SPROUT-MITLL/tip_mounts/media/tip_mount.png

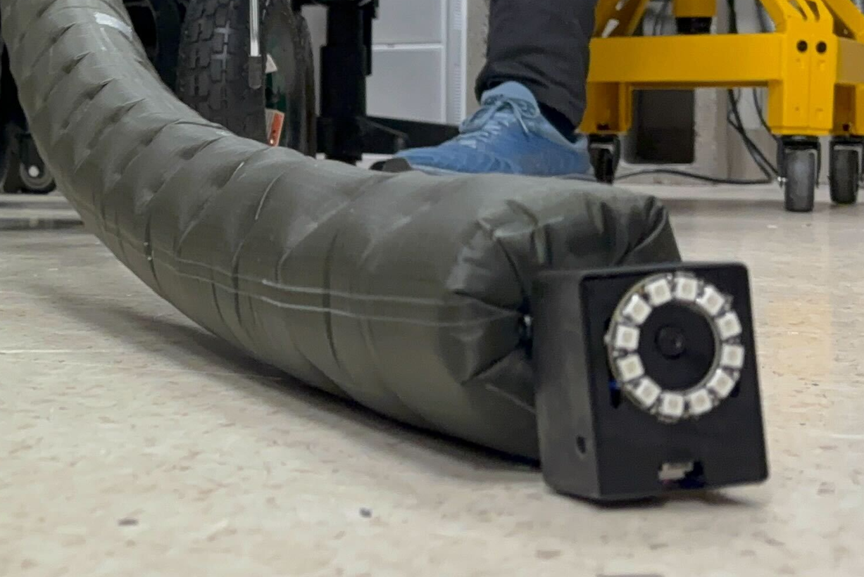
media/tip_mount.png
