SPROUT-MITLL/tip_mounts/media/mount.png

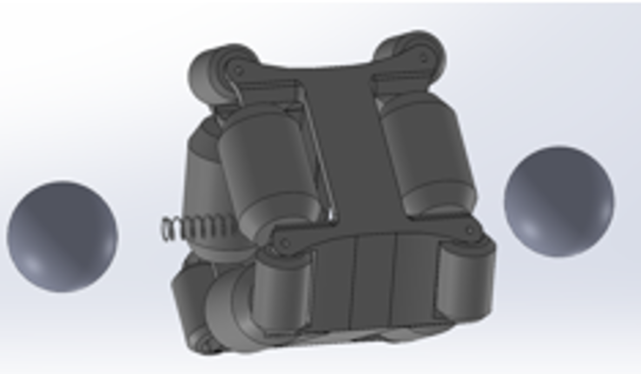
media/mount.png
