SPROUT-MITLL/tip_mounts/index_2.md

---
layout: default
title: Home
nav_order: 1
description: "Gotta Grow Fast"
permalink: /
---
<html lang="en-US">
<head>
  <meta charset="UTF-8">
  <meta name="viewport" content="width=device-width, initial-scale=1.0">
  <!--<link rel="stylesheet" href="style.css">-->
  <title>Gotta Grow Fast: Optimized Tip Mount & Benchmarking Methods for Growing Vine Robots</title>
</head>
<body>
  <div class="header-adder">
    <div class="title_set">
      <h1>Gotta Grow Fast: Optimized Tip Mount & Benchmarking Methods for Growing Vine Robots</h1>
    </div>
    <div class="names">
        <strong>
          Anonymous Authors
        </strong>
    </div>
  </div>
  <video width="1000" controls>
    <source src="media/gotta_grow_fast_v2.mp4" type="video/mp4">
  </video>

  <h2>Abstract</h2>
  <p>
  Soft, growing vine robots extend through tip eversion, a mechanism that enables navigation through cluttered environments. However, integrating cameras and other sensors at the tip is uniquely challenging because the material forming the tip is constantly renewed as the robot grows. This continual material turnover, combined with friction between internal layers, added tip weight, and fabric constriction, complicates sensor and tool mounting. These limitations hinder the deployment of vine robots for inspection and search tasks, where rapid growth while carrying tip-mounted sensors is essential.
  In this work, we present a triangular roller tip mount that reduces internal resistance during growth by rolling rather than sliding against the robot body. The design was refined through iterative failure analysis, enabling, for the first time, consistent eversion on a TPU-coated ripstop nylon vine robot.
  To quantitatively evaluate mount performance, we introduce a custom testbed that isolates tip-mounting effects by measuring tail tension during eversion. Comparative experiments across multiple mount variants, including prior designs, show that our triangular roller mount achieves the lowest tail tension and most repeatable growth performance.
  These results establish both a validated tip-mount design and a repeatable benchmarking framework for advancing sensor and tool integration in soft growing robots.
  </p>
</body>
</html>
---
