SPROUT-MITLL/tip_mounts/CAD/tip_mount/index.md

---
layout: default
title: Tip Mount CAD Files
nav_exclude: true
---

# Tip Mount CAD Files

[Back to Build Instructions](../../Build_Instructions){: .btn }

### 3D Preview: Camera Mount

{% include stl-viewer.html src="/media/camera_mount.stl" id="cad-camera-mount-viewer" %}

## Assembly

- [Final_Assembly.SLDASM](./Final_Assembly.SLDASM)

## Parts

- [rod.SLDPRT](./rod.SLDPRT)
- [sphere_anchor.SLDPRT](./sphere_anchor.SLDPRT)
- [V11_Small_Roller.SLDPRT](./V11_Small_Roller.SLDPRT)
- [V11_large_Roller.SLDPRT](./V11_large_Roller.SLDPRT)
- [V12_Half_Frame_Back_to_Back__SINGLE_PART_NOBORDER.SLDPRT](./V12_Half_Frame_Back_to_Back__SINGLE_PART_NOBORDER.SLDPRT)

## Purchased Hardware

- [6056N11_Carbon Steel Set Screw Collar.SLDPRT](./6056N11_Carbon%20Steel%20Set%20Screw%20Collar.SLDPRT)
