SPROUT-MITLL/tip_mounts/CAD/tip_mount/Final_Assembly.SLDASM

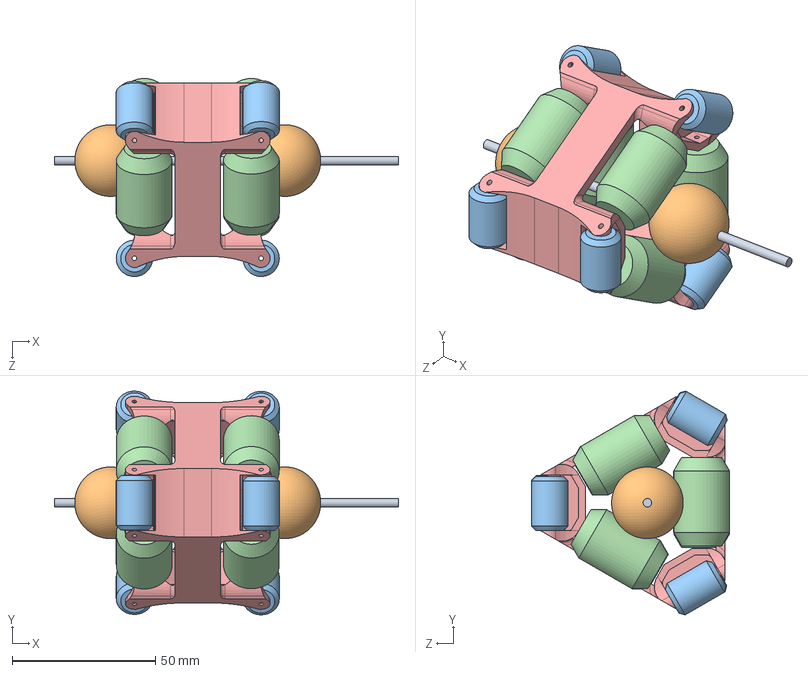
[picture p3: CAD file, 2025-11-18]
CAD/tip_mount/Final_Assembly.SLDASM
120.0 x 78.0 x 69.1 mm
V12_Half_Frame_Back_to_Back__SINGLE_PART_NOBORDER
V11_large_Roller x 6
V11_Small_Roller x 6
sphere_anchor x 2
rod
