SPROUT-MITLL/tip_mounts/CAD/test_bed/Short_Vine_Testbed_V1.SLDASM

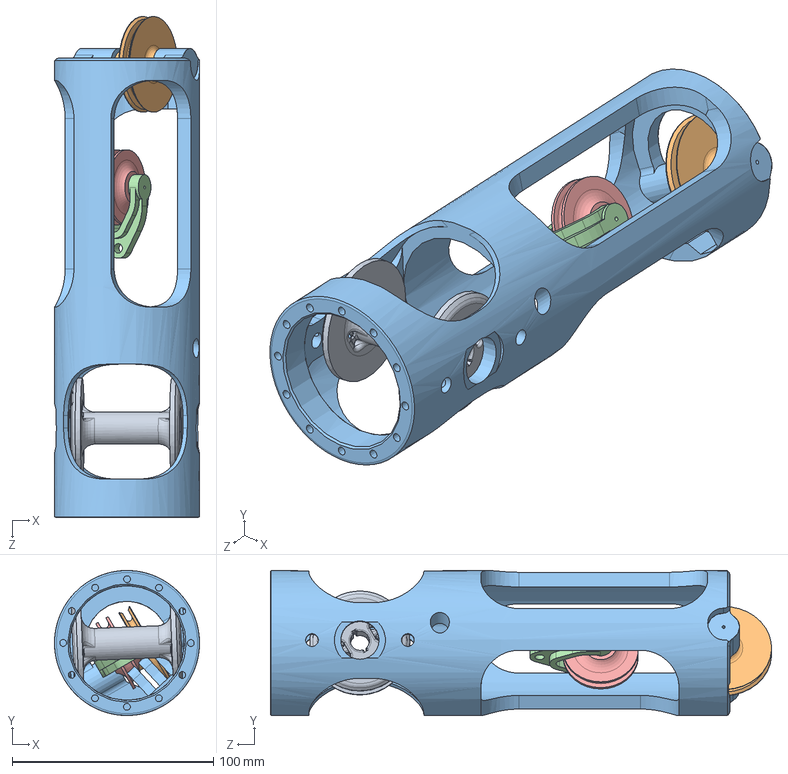
[picture p4: CAD file, 2025-11-18]
CAD/test_bed/Short_Vine_Testbed_V1.SLDASM
72.1 x 72.1 x 249.1 mm
Force_Sensor_Pulley
Force_Sensor_Pulley_Bracket
Force_Sensor_Stationary_Mount_Bracket
Return_Wheel
vine_retract_cable_reel
