SPROUT-MITLL/tip_mounts/CAD/test_bed/Sensor_Pulley_Bracket_Assembly.SLDASM

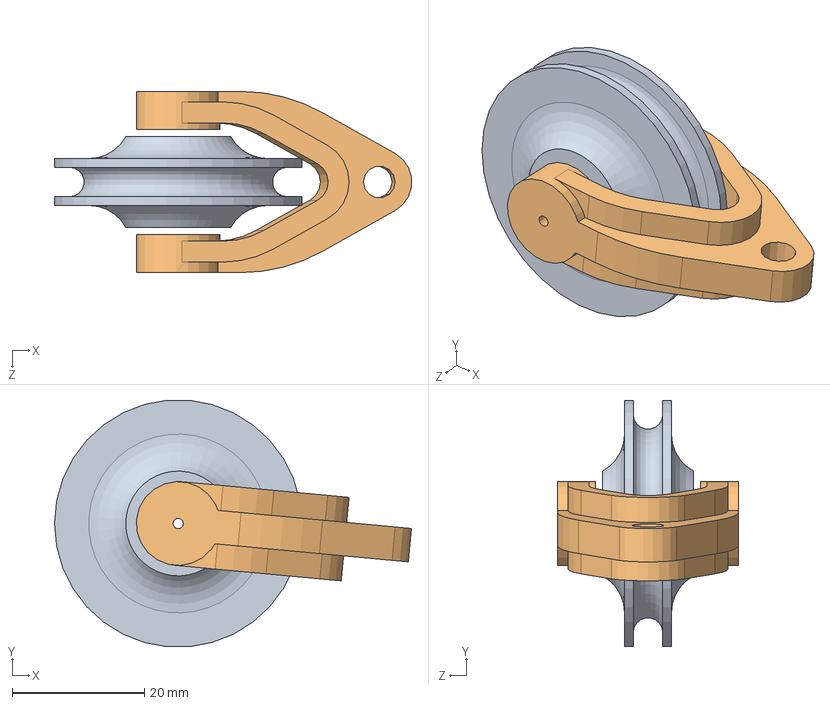
[picture p5: CAD file, 2025-11-18]
CAD/test_bed/Sensor_Pulley_Bracket_Assembly.SLDASM
54.1 x 37.3 x 27.4 mm
Force_Sensor_Pulley
Force_Sensor_Pulley_Bracket
