SPROUT-MITLL/tip_mounts/CAD/tip_mount/sphere_anchor.SLDPRT

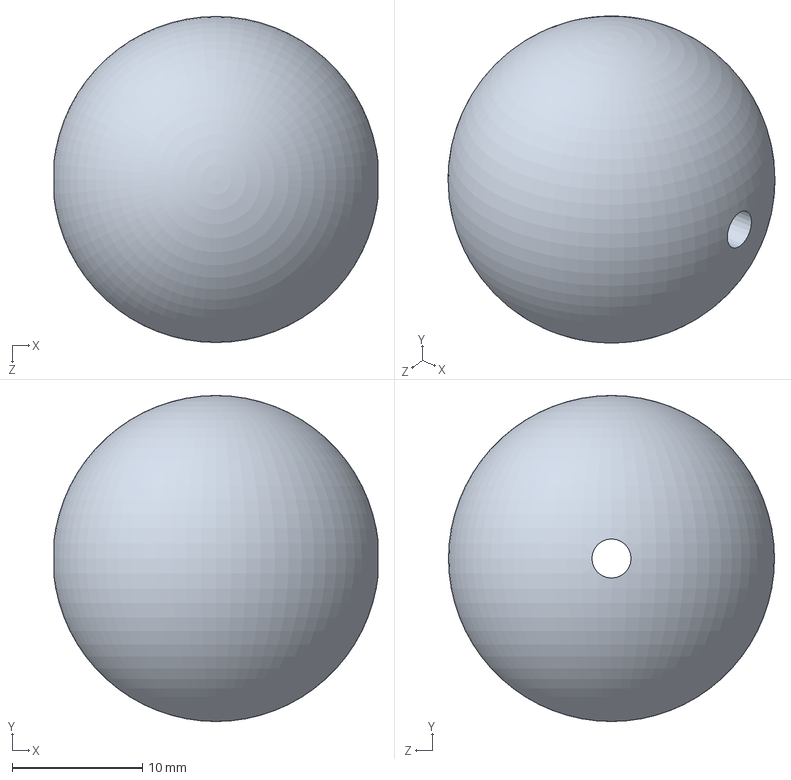
[picture p6: CAD file, 2025-11-18]
CAD/tip_mount/sphere_anchor.SLDPRT
24.8 x 25.0 x 25.0 mm
