SPROUT-MITLL/tip_mounts/media/camera_mount.stl

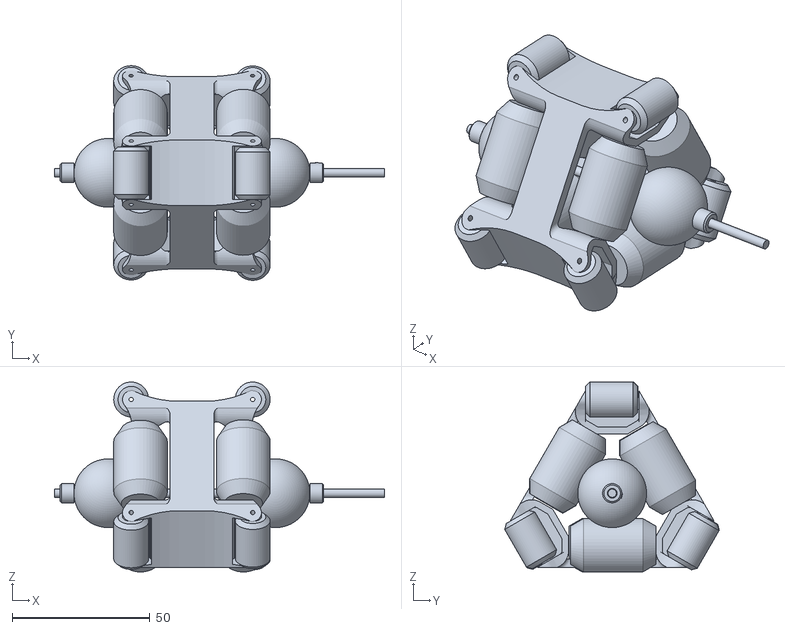
[picture p7: CAD file, 2026-08-28]
media/camera_mount.stl
120.0 x 78.1 x 69.1
