SPROUT-MITLL/tip_mounts/CAD/test_bed/Return_Wheel.SLDPRT

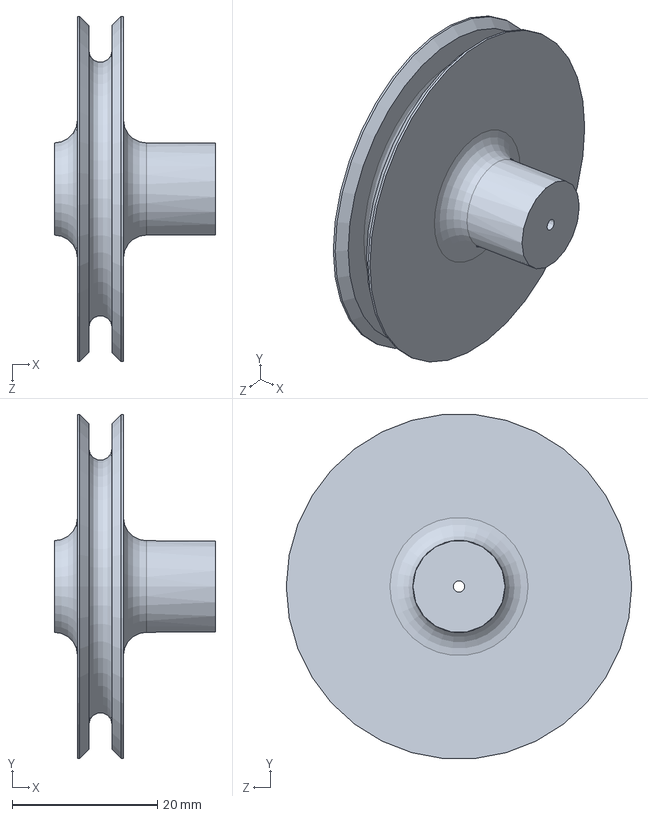
[picture p8: CAD file, 2025-11-18]
CAD/test_bed/Return_Wheel.SLDPRT
22.2 x 47.4 x 47.6 mm
