SPROUT-MITLL/tip_mounts/CAD/tip_mount/rod.SLDPRT

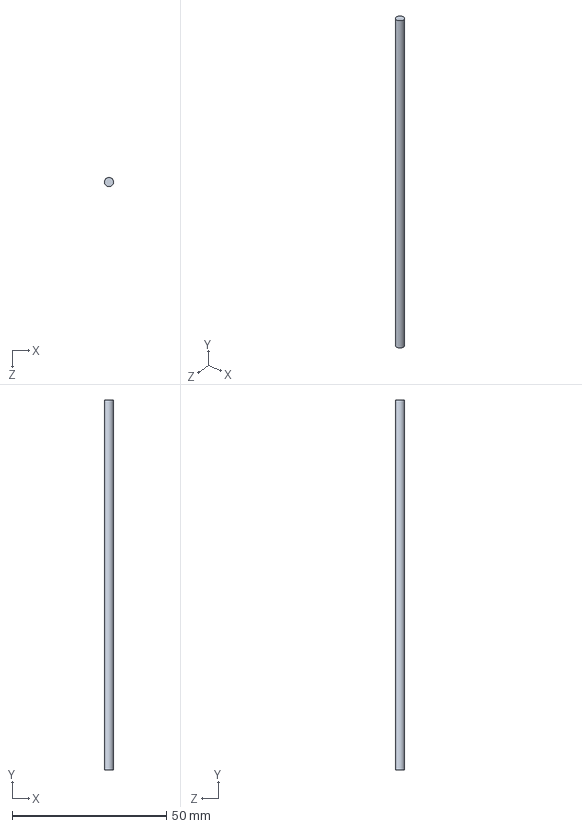
[picture p9: CAD file, 2025-11-18]
CAD/tip_mount/rod.SLDPRT
2.99 x 120.0 x 3.00 mm
