SPROUT-MITLL/tip_mounts/CAD/test_bed/vine_retract_cable_reel.SLDPRT

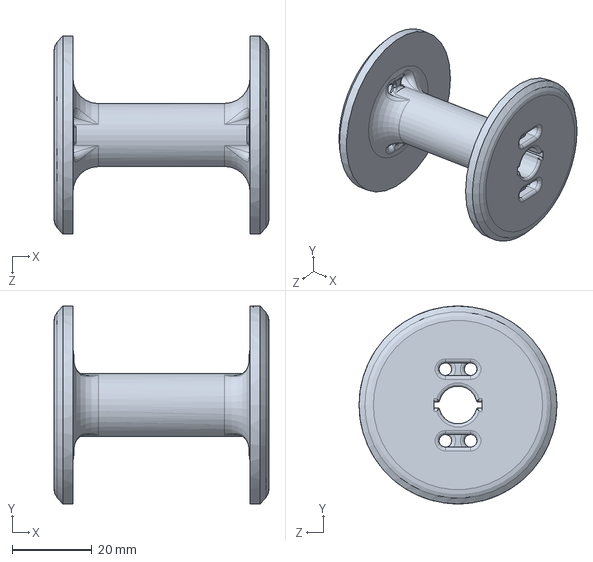
[picture p10: CAD file, 2025-11-18]
CAD/test_bed/vine_retract_cable_reel.SLDPRT
54.0 x 49.7 x 49.7 mm
