SPROUT-MITLL/tip_mounts/CAD/tip_mount/V11_Small_Roller.SLDPRT

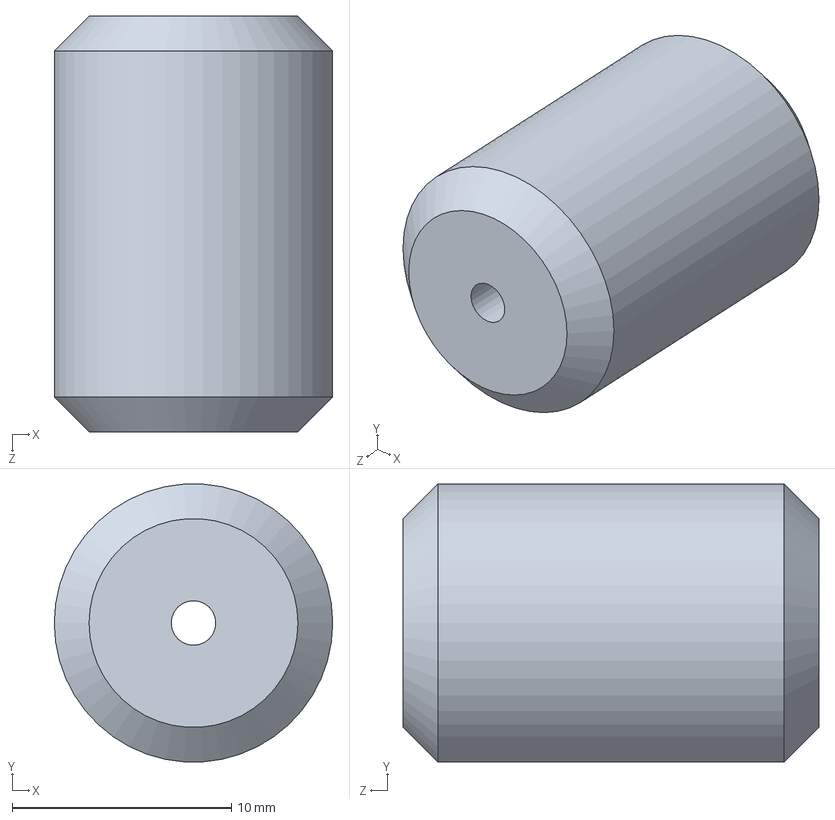
[picture p11: CAD file, 2025-11-18]
CAD/tip_mount/V11_Small_Roller.SLDPRT
12.7 x 12.7 x 19.0 mm
