SPROUT-MITLL/tip_mounts/CAD/test_bed/PTFE ring.SLDPRT

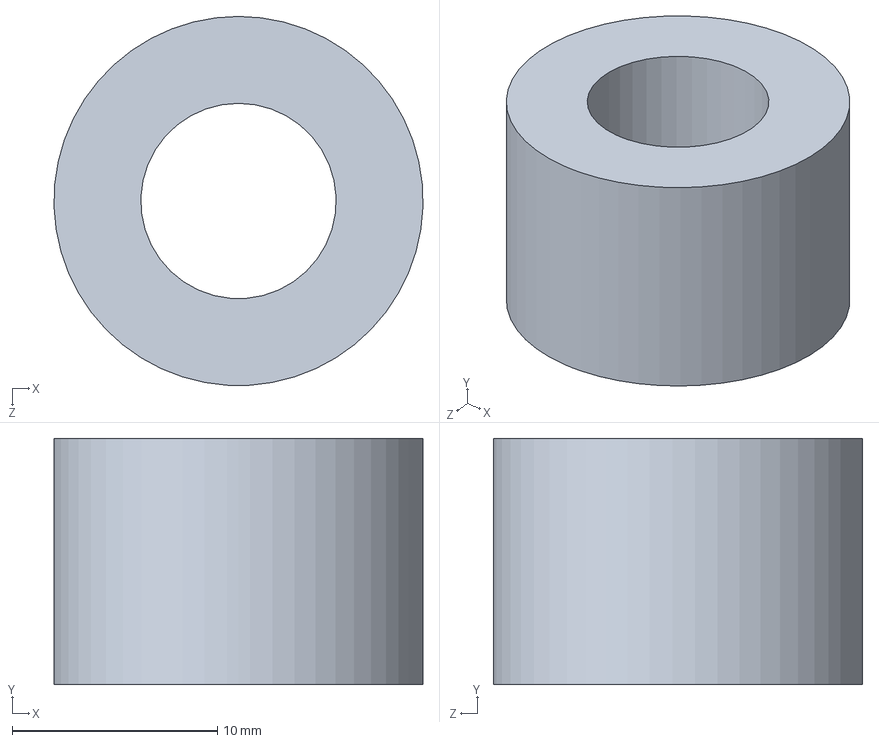
[picture p12: CAD file, 2025-11-18]
CAD/test_bed/PTFE ring.SLDPRT
18.0 x 12.0 x 18.0 mm
