SPROUT-MITLL/tip_mounts/CAD/tip_mount/V11_large_Roller.SLDPRT

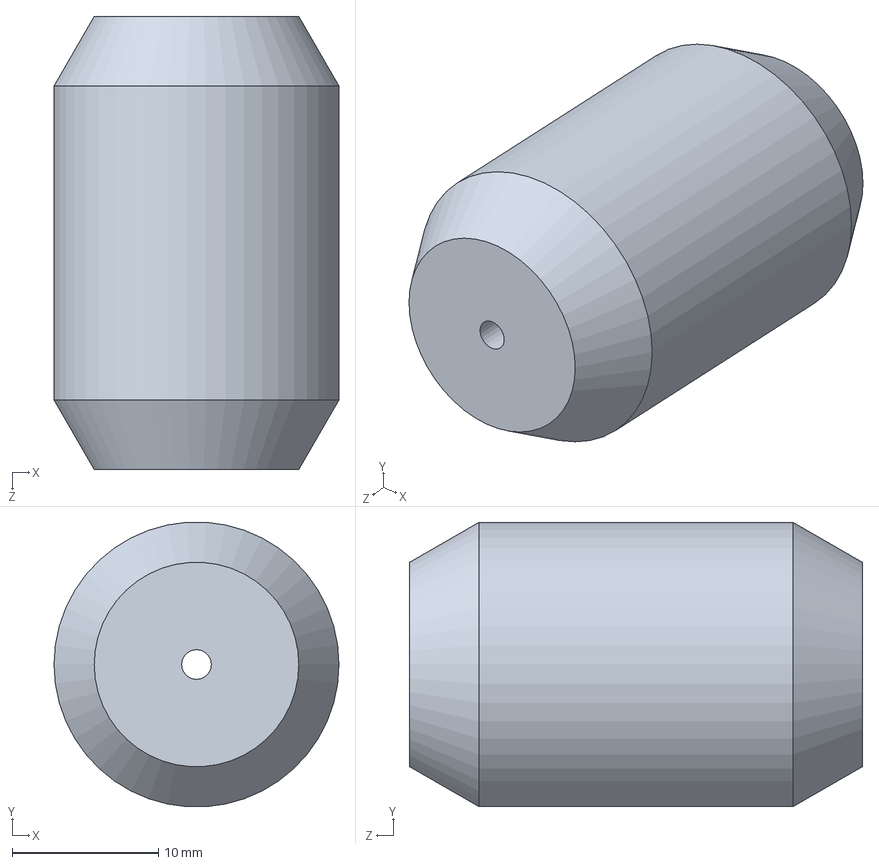
[picture p13: CAD file, 2025-11-18]
CAD/tip_mount/V11_large_Roller.SLDPRT
19.5 x 19.4 x 31.0 mm
