SPROUT-MITLL/tip_mounts/CAD/tip_mount/V12_Half_Frame_Back_to_Back__SINGLE_PART_NOBORDER.SLDPRT

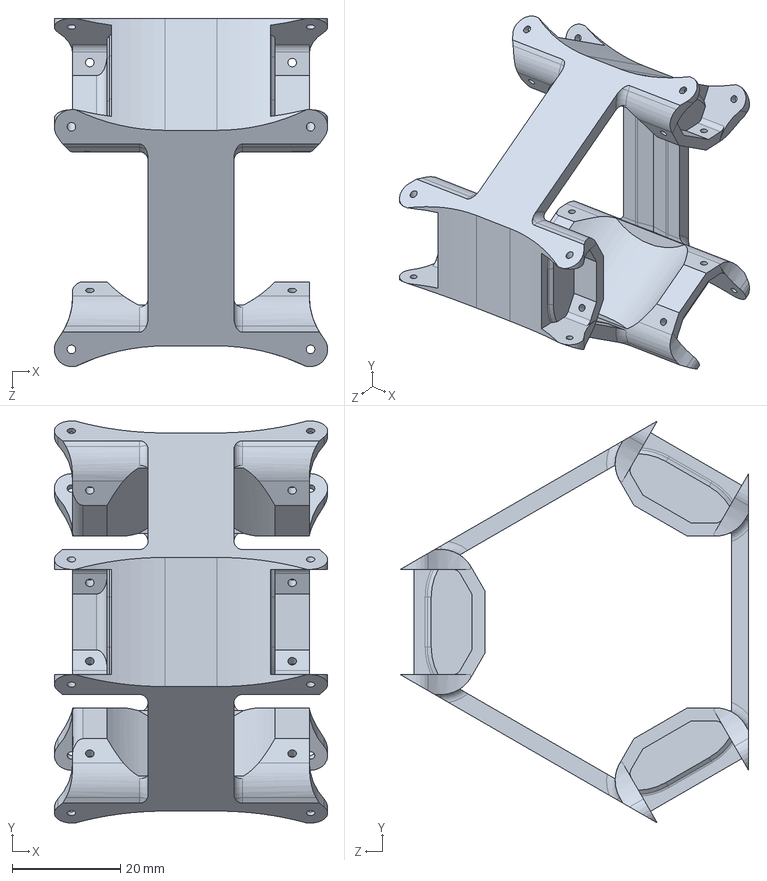
[picture p14: CAD file, 2025-11-18]
CAD/tip_mount/V12_Half_Frame_Back_to_Back__SINGLE_PART_NOBORDER.SLDPRT
50.5 x 74.3 x 64.3 mm
