SPROUT-MITLL/tip_mounts/CAD/test_bed/shaft_bushing.SLDPRT

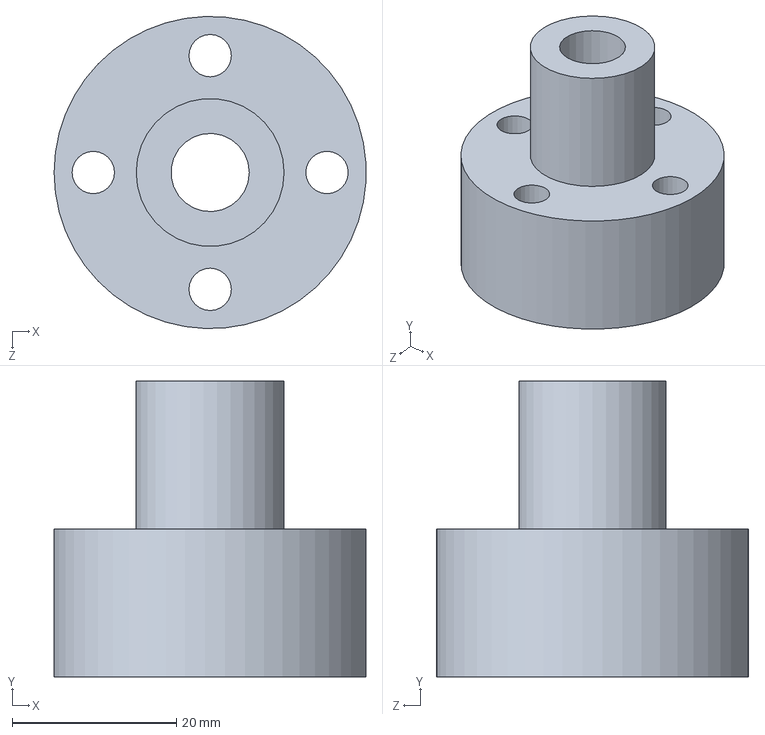
[picture p15: CAD file, 2025-11-18]
CAD/test_bed/shaft_bushing.SLDPRT
38.0 x 36.0 x 38.0 mm
