SPROUT-MITLL/tip_mounts/CAD/test_bed/cap.SLDPRT

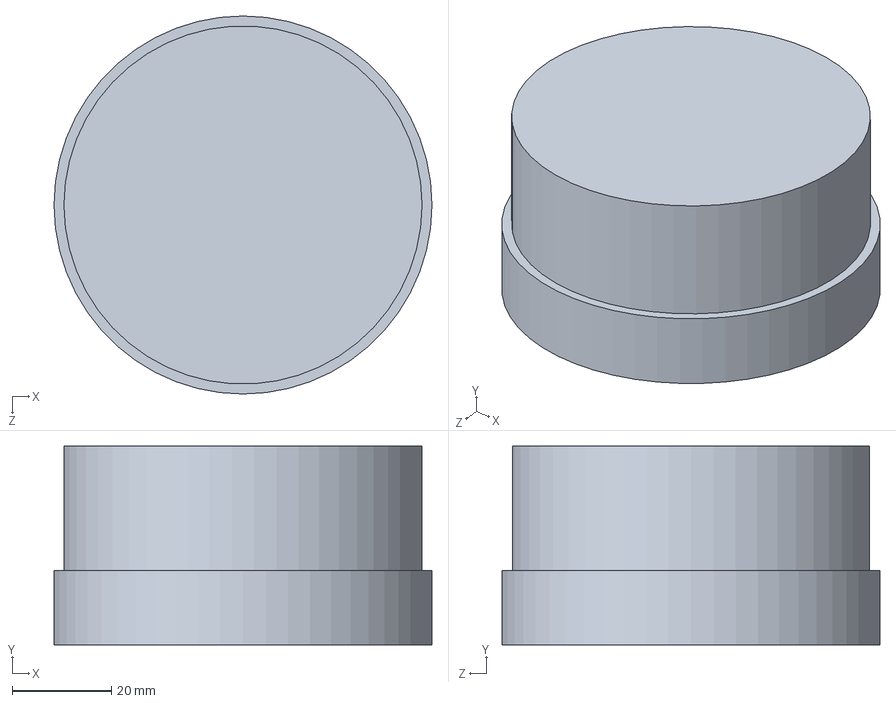
[picture p16: CAD file, 2025-11-18]
CAD/test_bed/cap.SLDPRT
76.0 x 40.0 x 76.0 mm
