SPROUT-MITLL/tip_mounts/CAD/test_bed/airtight_chamber_adapter.SLDPRT

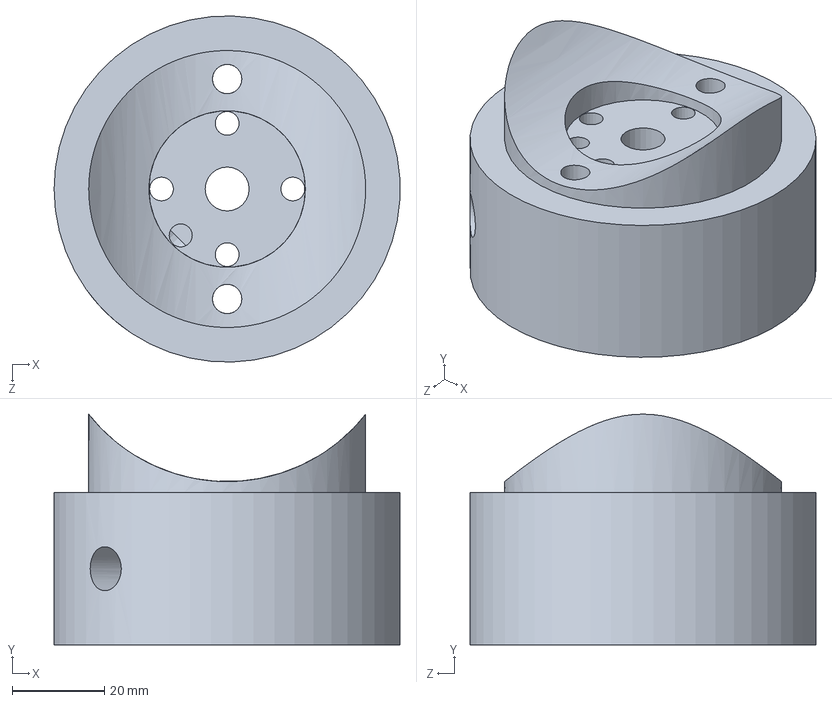
[picture p17: CAD file, 2025-11-18]
CAD/test_bed/airtight_chamber_adapter.SLDPRT
74.9 x 50.0 x 75.0 mm
