SPROUT-MITLL/tip_mounts/CAD/test_bed/Force_Sensor_Pulley_Bracket.SLDPRT

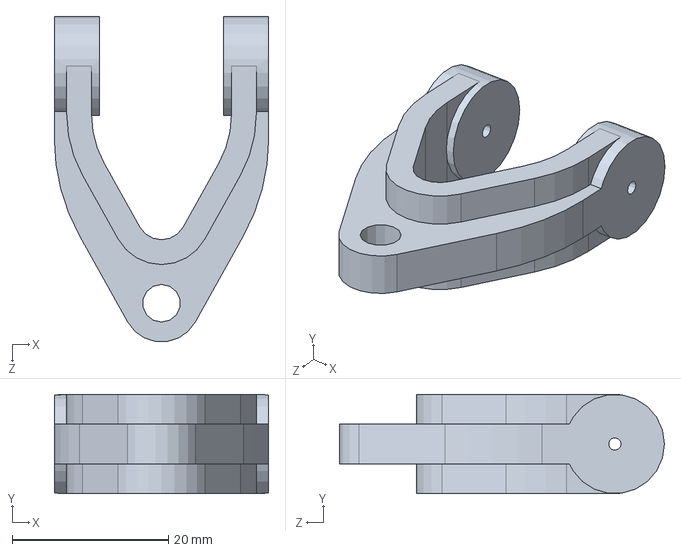
[picture p18: CAD file, 2025-11-18]
CAD/test_bed/Force_Sensor_Pulley_Bracket.SLDPRT
27.4 x 12.7 x 41.6 mm
