SPROUT-MITLL/tip_mounts/CAD/test_bed/belt.SLDPRT

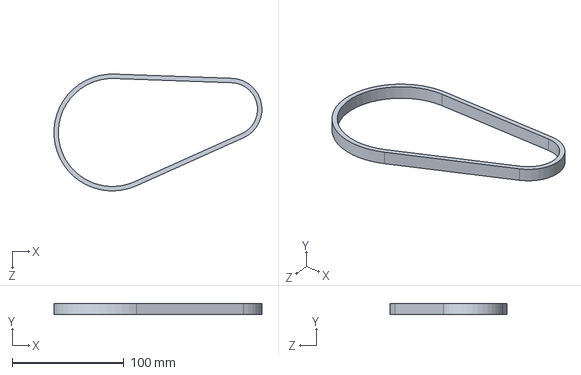
[picture p19: CAD file, 2025-11-18]
CAD/test_bed/belt.SLDPRT
185.9 x 10.0 x 104.5 mm
