SPROUT-MITLL/tip_mounts/CAD/test_bed/motor.SLDPRT

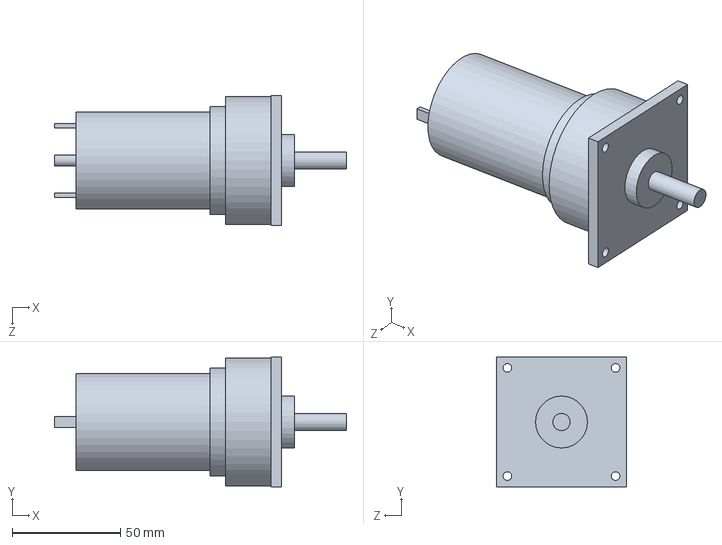
[picture p20: CAD file, 2025-11-18]
CAD/test_bed/motor.SLDPRT
135.0 x 60.0 x 60.0 mm
