SPROUT-MITLL/tip_mounts/CAD/test_bed/Futek_Sensor.SLDPRT

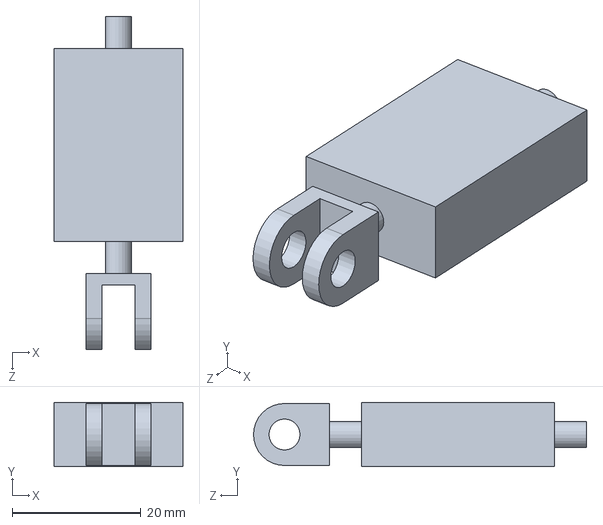
[picture p21: CAD file, 2025-11-18]
CAD/test_bed/Futek_Sensor.SLDPRT
20.0 x 10.0 x 51.8 mm
