SPROUT-MITLL/tip_mounts/CAD/test_bed/single_mount.SLDPRT

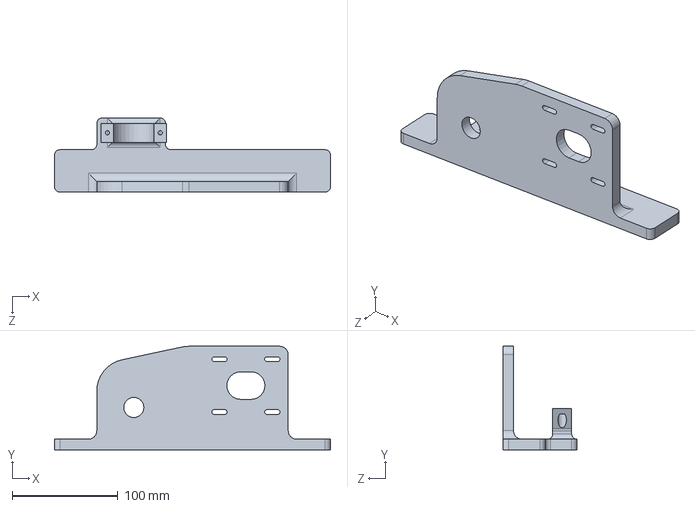
[picture p22: CAD file, 2025-11-18]
CAD/test_bed/single_mount.SLDPRT
261.0 x 97.9 x 70.0 mm
