SPROUT-MITLL/tip_mounts/CAD/test_bed/Force_Sensor_Stationary_Mount_Bracket.SLDPRT

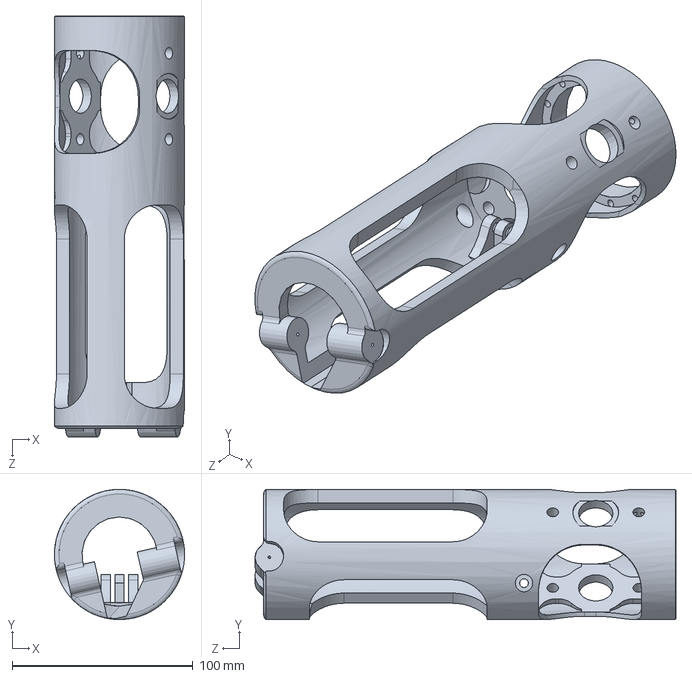
[picture p23: CAD file, 2025-11-18]
CAD/test_bed/Force_Sensor_Stationary_Mount_Bracket.SLDPRT
72.1 x 72.1 x 233.2 mm
