SPROUT-MITLL/tip_mounts/CAD/test_bed/Clear_Tube_Section.SLDPRT

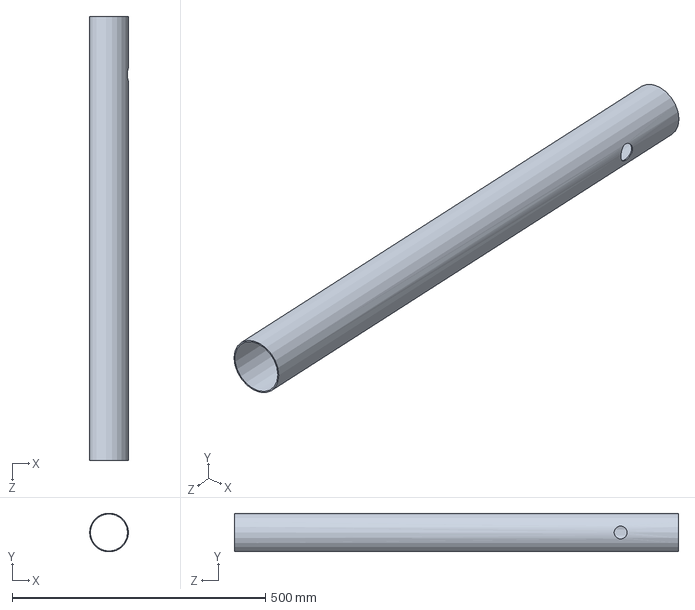
[picture p24: CAD file, 2025-11-18]
CAD/test_bed/Clear_Tube_Section.SLDPRT
76.7 x 75.9 x 876.3 mm
