SPROUT-MITLL/tip_mounts/CAD/test_bed/shaft_clamp_p1.SLDPRT

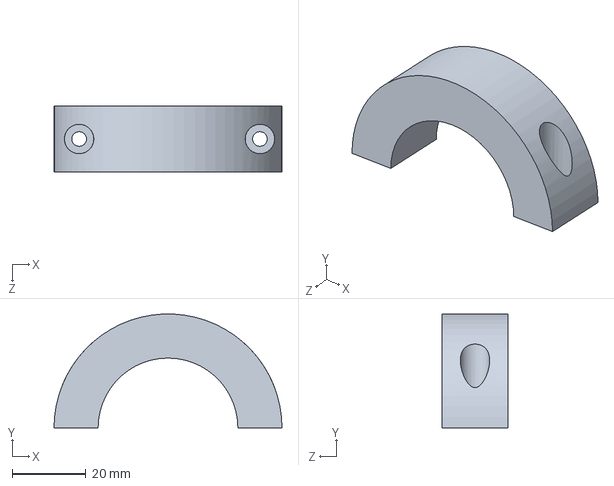
[picture p25: CAD file, 2025-11-18]
CAD/test_bed/shaft_clamp_p1.SLDPRT
62.0 x 31.0 x 18.0 mm
