SPROUT-MITLL/tip_mounts/CAD/test_bed/Force_Sensor_Pulley.SLDPRT

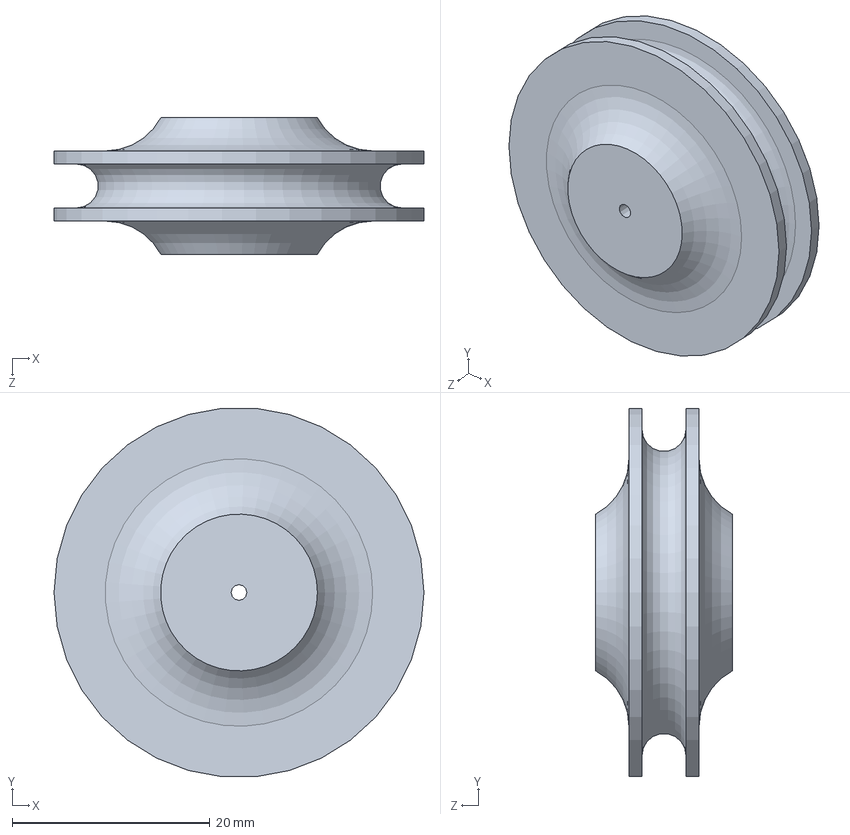
[picture p26: CAD file, 2025-11-18]
CAD/test_bed/Force_Sensor_Pulley.SLDPRT
37.5 x 37.3 x 13.8 mm
