SPROUT-MITLL/tip_mounts/CAD/test_bed/shaft_bushing_inner.SLDPRT

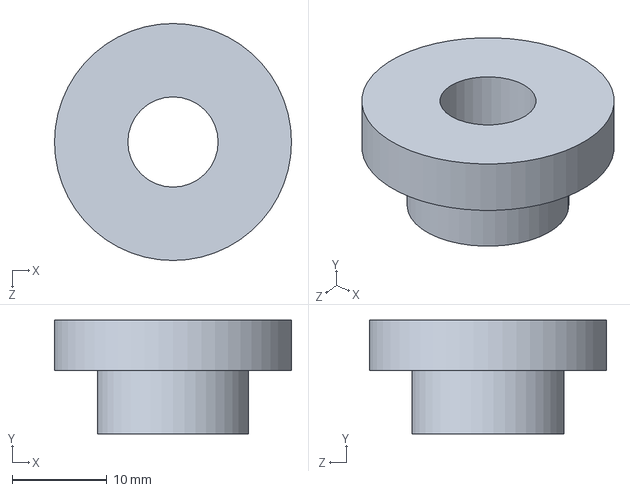
[picture p27: CAD file, 2025-11-18]
CAD/test_bed/shaft_bushing_inner.SLDPRT
25.0 x 12.0 x 25.0 mm
