SPROUT-MITLL/tip_mounts/CAD/test_bed/single_mount_assembly.SLDASM

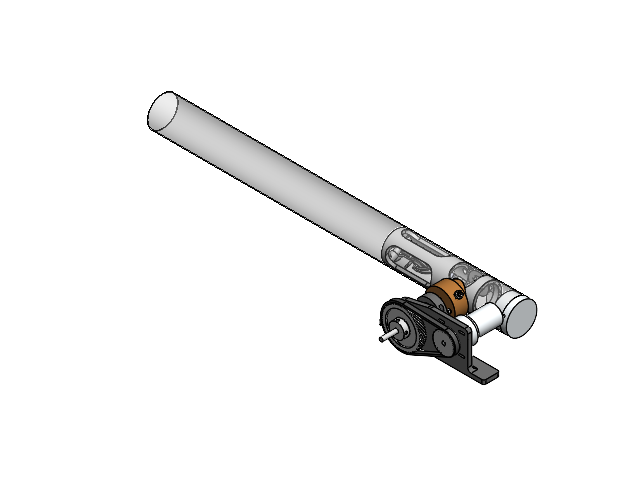
[picture p28: CAD file, 2025-11-25]
CAD/test_bed/single_mount_assembly.SLDASM
single_mount
motor
2705T55_Light Duty Dry-Running Flanged Sleeve Bearing
shaft_bushing
shaft_clamp_p1
1277N61_Corrosion-Resistant Timing Belt Pulley
1346K511_Rotary Shaft
airtight_chamber_adapter
Clear_Tube_Section
1277N768_Corrosion-Resistant Timing Belt Pulley
Force_Sensor_Pulley
Force_Sensor_Pulley_Bracket
Force_Sensor_Stationary_Mount_Bracket
Return_Wheel
vine_retract_cable_reel
cap
PTFE ring
shaft_bushing_inner
5779K109_Push-to-Connect Tube Fitting for Air
belt
91251A548_Black-Oxide Alloy Steel Socket Head Screw x 2
Futek_Sensor
90044A115_Black-Oxide Alloy Steel Socket Head Screw x 4
