SPROUT-MITLL/tip_mounts/(list of files, cad)

Other CAD files:
CAD/test_bed/1277N61_Corrosion-Resistant Timing Belt Pulley.SLDPRT
CAD/test_bed/1277N768_Corrosion-Resistant Timing Belt Pulley.SLDPRT
CAD/test_bed/1346K511_Rotary Shaft.SLDPRT
CAD/test_bed/2705T55_Light Duty Dry-Running Flanged Sleeve Bearing.SLDPRT
CAD/test_bed/5779K109_Push-to-Connect Tube Fitting for Air.SLDPRT
CAD/test_bed/90044A115_Black-Oxide Alloy Steel Socket Head Screw.SLDPRT
CAD/test_bed/91251A548_Black-Oxide Alloy Steel Socket Head Screw.SLDPRT
CAD/tip_mount/6056N11_Carbon Steel Set Screw Collar.SLDPRT
