SPROUT-MITLL/tip_mounts/Build_Instructions.md

---
layout: default
title: Build Instructions
nav_order: 3
---

# CAD Files

## [Tip Mount](./CAD/tip_mount/)

## [Testbed](./CAD/test_bed/)
