SPROUT-MITLL/tip_mounts/CAD/test_bed/index.md

---
layout: default
title: Testbed CAD Files
nav_exclude: true
---

# Testbed CAD Files

[Back to Build Instructions](../../Build_Instructions){: .btn }

## Assemblies

- [Short_Vine_Testbed_V1.SLDASM](./Short_Vine_Testbed_V1.SLDASM)
- [Sensor_Pulley_Bracket_Assembly.SLDASM](./Sensor_Pulley_Bracket_Assembly.SLDASM)
- [single_mount_assembly.SLDASM](./single_mount_assembly.SLDASM)

## Parts

- [airtight_chamber_adapter.SLDPRT](./airtight_chamber_adapter.SLDPRT)
- [belt.SLDPRT](./belt.SLDPRT)
- [cap.SLDPRT](./cap.SLDPRT)
- [Clear_Tube_Section.SLDPRT](./Clear_Tube_Section.SLDPRT)
- [Force_Sensor_Pulley.SLDPRT](./Force_Sensor_Pulley.SLDPRT)
- [Force_Sensor_Pulley_Bracket.SLDPRT](./Force_Sensor_Pulley_Bracket.SLDPRT)
- [Force_Sensor_Stationary_Mount_Bracket.SLDPRT](./Force_Sensor_Stationary_Mount_Bracket.SLDPRT)
- [Futek_Sensor.SLDPRT](./Futek_Sensor.SLDPRT)
- [motor.SLDPRT](./motor.SLDPRT)
- [PTFE ring.SLDPRT](./PTFE%20ring.SLDPRT)
- [Return_Wheel.SLDPRT](./Return_Wheel.SLDPRT)
- [shaft_bushing.SLDPRT](./shaft_bushing.SLDPRT)
- [shaft_bushing_inner.SLDPRT](./shaft_bushing_inner.SLDPRT)
- [shaft_clamp_p1.SLDPRT](./shaft_clamp_p1.SLDPRT)
- [single_mount.SLDPRT](./single_mount.SLDPRT)
- [vine_retract_cable_reel.SLDPRT](./vine_retract_cable_reel.SLDPRT)

## Purchased Hardware

- [1277N61_Corrosion-Resistant Timing Belt Pulley.SLDPRT](./1277N61_Corrosion-Resistant%20Timing%20Belt%20Pulley.SLDPRT)
- [1277N768_Corrosion-Resistant Timing Belt Pulley.SLDPRT](./1277N768_Corrosion-Resistant%20Timing%20Belt%20Pulley.SLDPRT)
- [1346K511_Rotary Shaft.SLDPRT](./1346K511_Rotary%20Shaft.SLDPRT)
- [2705T55_Light Duty Dry-Running Flanged Sleeve Bearing.SLDPRT](./2705T55_Light%20Duty%20Dry-Running%20Flanged%20Sleeve%20Bearing.SLDPRT)
- [5779K109_Push-to-Connect Tube Fitting for Air.SLDPRT](./5779K109_Push-to-Connect%20Tube%20Fitting%20for%20Air.SLDPRT)
- [90044A115_Black-Oxide Alloy Steel Socket Head Screw.SLDPRT](./90044A115_Black-Oxide%20Alloy%20Steel%20Socket%20Head%20Screw.SLDPRT)
- [91251A548_Black-Oxide Alloy Steel Socket Head Screw.SLDPRT](./91251A548_Black-Oxide%20Alloy%20Steel%20Socket%20Head%20Screw.SLDPRT)
