SPROUT-MITLL/tip_mounts/media/results.png

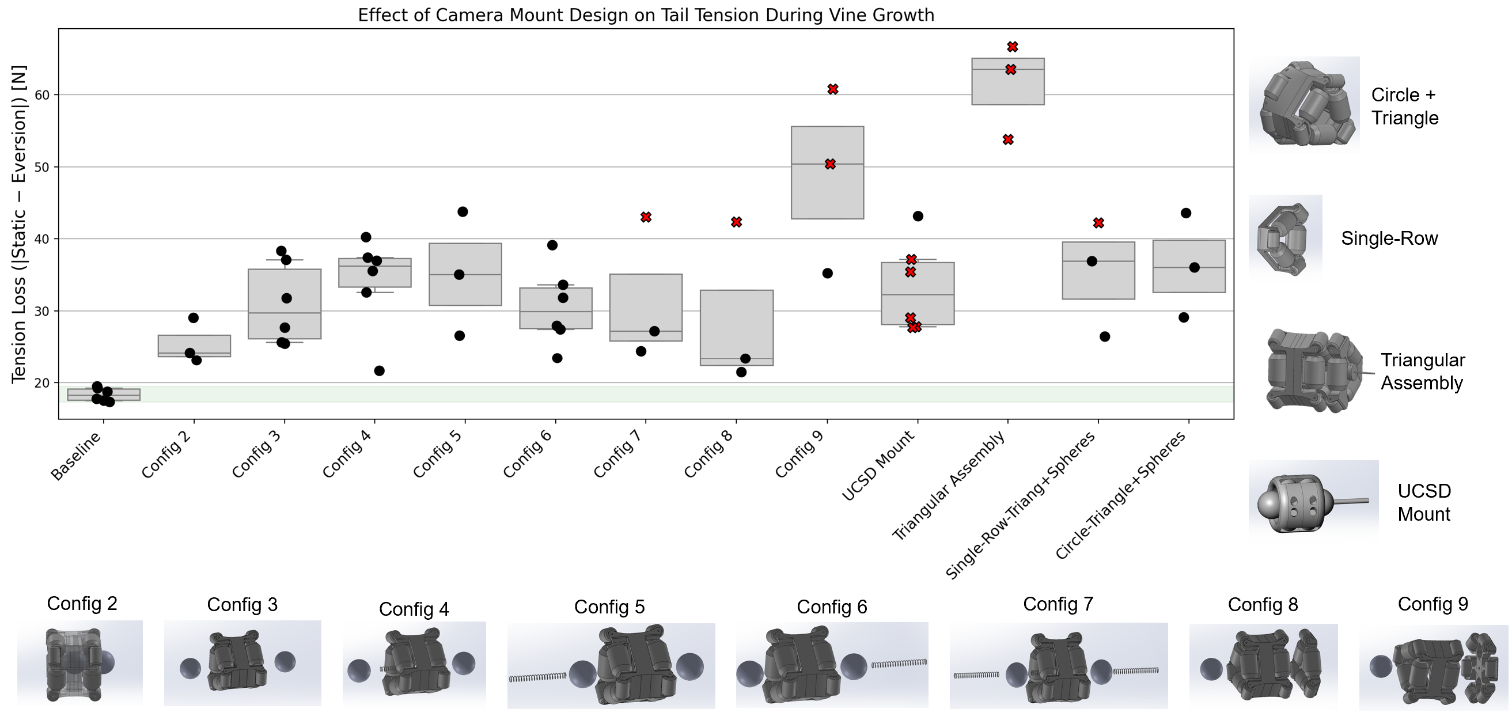
media/results.png
