SPROUT-MITLL/tip_mounts/(commit log)

2025-11-17 adds tip mount video
2025-11-18 adds CAD folder
2025-11-18 Add: Testbed CAD
    [1277N61_Corrosion-Resistant Timing Belt Pulley.SLDPRT, 1277N768_Corrosion-Resistant Timing Belt Pulley.SLDPRT, 1346K511_Rotary Shaft.SLDPRT, 2705T55_Light Duty Dry-Running Flanged Sleeve Bearing.SLDPRT, 5779K109_Push-to-Connect Tube Fitting for Air.SLDPRT, 91251A157_Black-Oxide Alloy Steel Socket Head Screw.SLDPRT, 91251A548_Black-Oxide Alloy Steel Socket Head Screw.SLDPRT, Clear_Tube_Section.SLD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]
2025-11-18 Add: Tip mount CAD
    [6056N11_Carbon Steel Set Screw Collar.SLDPRT, Final_Assembly.SLDASM, V11_Small_Roller.SLDPRT, V11_large_Roller.SLDPRT, V12_Half_Frame_Back_to_Back__SINGLE_PART_NOBORDER.SLDPRT, rod.SLDPRT, sphere_anchor.SLDPRT]
2025-11-18 adds links to CAD
2025-11-18 adds skeleton BOM
2025-11-25 Update: testbed CAD
    [90044A115_Black-Oxide Alloy Steel Socket Head Screw.SLDPRT, 91251A157_Black-Oxide Alloy Steel Socket Head Screw.SLDPRT, single_mount_assembly.SLDASM]
2026-08-28 fixes errors
    [camera_mount.stl]
2026-08-28 adds missing includes for STL viewer
2026-08-28 fixes path for CAD model
2026-08-28 adds updated camera mount
    [camera_mount.stl]
